SCAI-Lab/ros4healthcare/README.md

<h1 align="center">
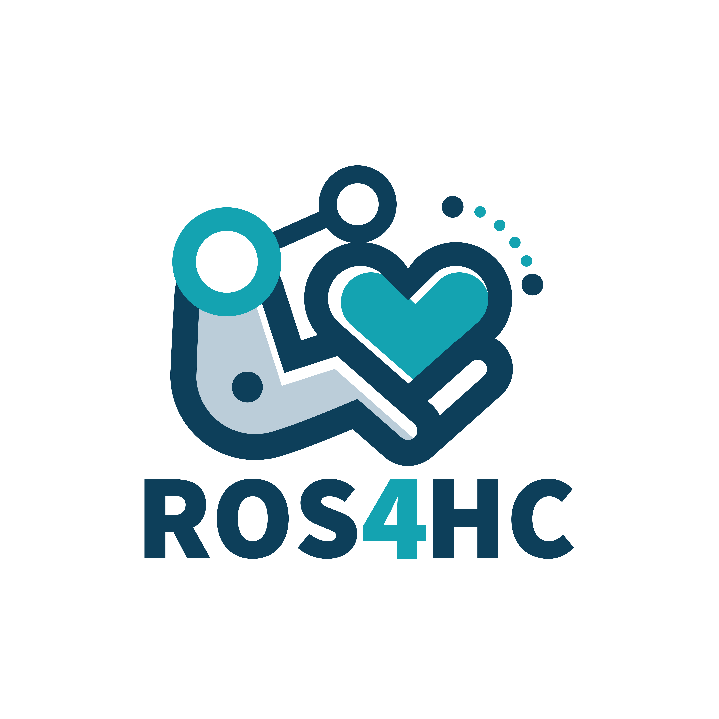
[picture p1: assets/ROS4HC_Logo.png]

</h1><br>

# ROS4Healthcare

Welcome to the **ROS4Healthcare** project! This repository contains ROS2 packages for healthcare applications, including message definitions, drivers, libraries, tools, and examples. **`ros4hc`** serves as an example of how one can use biosignals coming from wearable medical devices like Vivalink and mbient wristbands to track patients' activities. In addition, we have developed an Activities of Daily Living (ADL) classifier that will help doctors visualize their patients' daily activity patterns and consequently help them recommend a suitable routine. This can be visualised through our `healthcare_wheelchair_dashboard`.

## Repository Structure

- **`ros4hc_drv`**: Includes drivers for various biosensors.
- **`ros4hc_examples`**: Example applications and use cases demonstration.
- **`ros4hc_lib`**: Libraries.
- **`ros4hc_msgs`**: Contains all message definitions and structure for sensor data.
- **`ros4hc_launch`**: Example launch files.
- **`ros4hc_devices`**: Buildable affordable devices that work with ROS4HC.

## Setup

## **Prerequisites**
- Ensure **ROS 2 Humble** installed.

- Source ROS 2 :
  ```bash
  source /opt/ros/humble/setup.bash
  ```

Now clone the repo into our workspace

```bash
mkdir -p ~/ros2_ws/src
cd ~/ros2_ws/src
git clone --recurse-submodules https://github.com/ros-healthcare/ros4healthcare
cd ~/ros4healthcare
```
### **Build `ros4hc_msgs` and `ros4hc_drv`**
```bash
colcon build --packages-select ros4hc_msgs ros4hc_drv --symlink-install
source install/setup.bash
```

## Running the Drivers

We have included drivers for several devices in the `ros4hc_drv` repository.

Each driver receives either a device mac address or a file path as a parameter. Feel free to change the parameters in the respective config/params.yaml
file for each device driver.

To run the driver for BLE devices, make sure the PC Bluetooth is on, the device is charged and is nearby, then run the driver

by running ```ros2 launch package_name launch_file```  

To run our dashboard, we will need to connect to the mbient sensor and to the sensomative mat, for this run:

```
ros2 launch mbient_ros mbient_node.launch.py
```

in a new terminal, source the repo and run the sensomative launch file

```
source install/setup.bash
ros2 launch sensomative_ros sensomative_node.launch.py
```

## Running ADL Classifier 

In order to have our model classify the data coming from the wearable devices, we need to run the healthcare_adl_classifier

To do this open a new tab, source the repo and run

```
source install/setup.bash
ros2 run healthcare_adl_classifier pub_adl
```

We first need to make sure our python environment is well set up

simply run ```pip install -r requirements.txt``` to install the dependencies

We then need to clone the repositories into our workspace

```bash
cd ros2_ws/src
git clone --recurse-submodules https://github.com/ros-healthcare/ros4healthcare
cd ..
```
then build and source the workspace 

```
colcon build --symlink-install
source install/setup.bash
```

# Acknowledgments

<!-- ![JST Moonshot R&D Logo](https://example.com/jst_logo.png)  ![ETH-SPS Logo](https://example.com/eth_logo.png) -->

This work was partially supported by:

- The JST Moonshot R&D Program [Grant Number JPMJMS2034]
- The ETH-SPS Digital Transformation in Personalized Health Care for SCI [Grant Number: 2021-HS-348]

<h1 align="center">
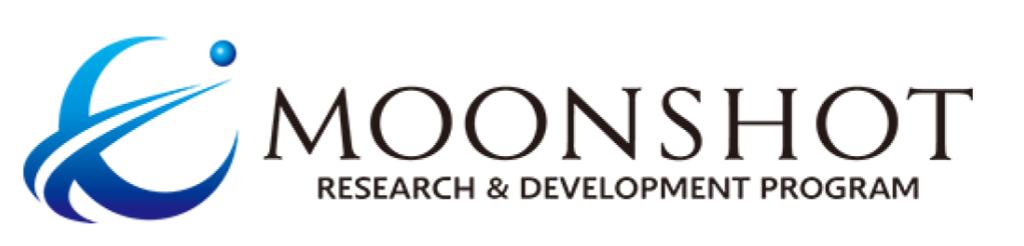
[picture p2: assets/JST_Logo.png]

</h1><br>
