SCAI-Lab/ros4healthcare/ros4hc_devices/M5StickC PLUS2/README.md

*M5StickC PLUS2 as an Accelerometer sensor*

This is the base code for using the M5StickC PLUS2 as a ROS2 compatible accelerometer sensor
