SCAI-Lab/ros4healthcare/ros4hc_examples/applications/healthcare_wheelchair_dashboard/dashboard/resource/Dashboard-Vectors/CircleProcess.png

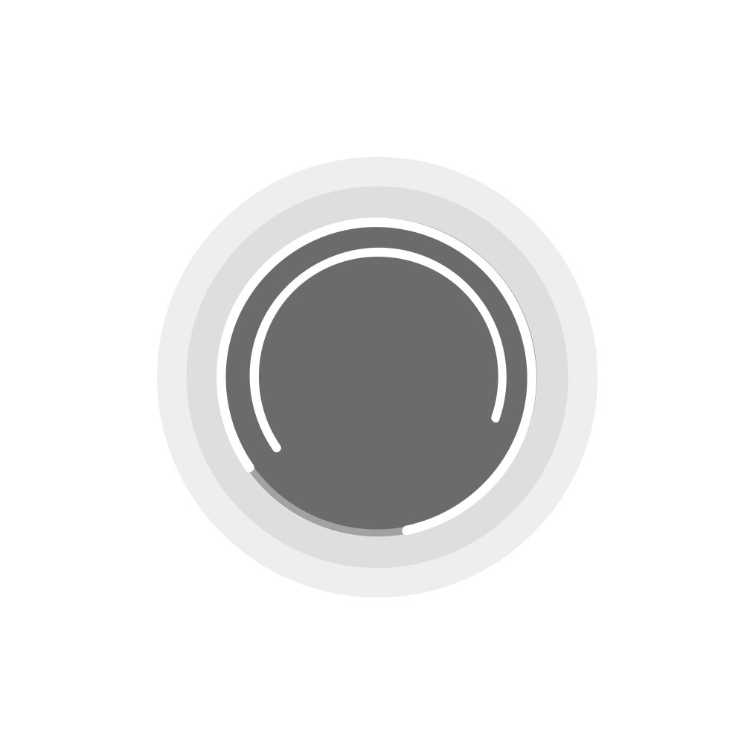
ros4hc_examples/applications/healthcare_wheelchair_dashboard/dashboard/resource/Dashboard-Vectors/CircleProcess.png
