SCAI-Lab/ros4healthcare/ros4hc_examples/applications/healthcare_wheelchair_dashboard/dashboard/resource/Dashboard-Vectors/Sleep_Pose_Left.png

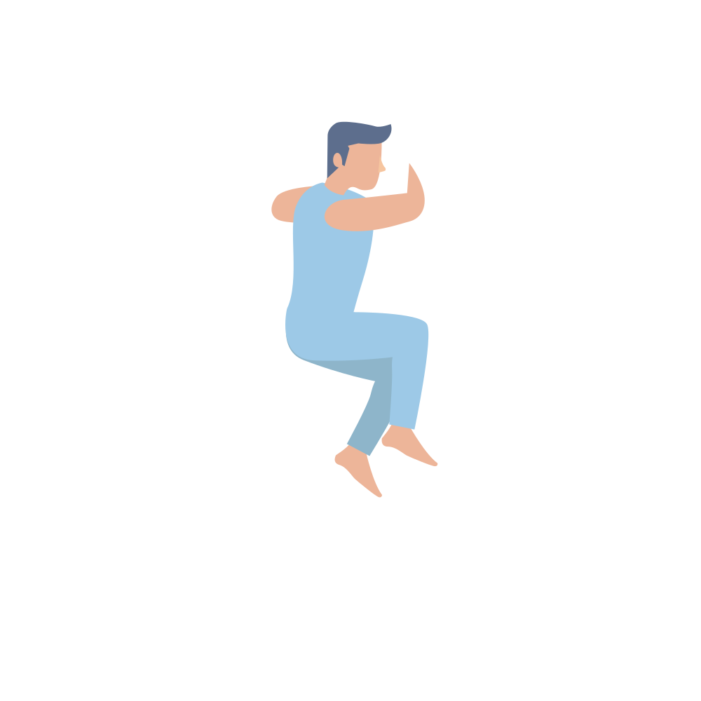
ros4hc_examples/applications/healthcare_wheelchair_dashboard/dashboard/resource/Dashboard-Vectors/Sleep_Pose_Left.png
