SCAI-Lab/ros4healthcare/ros4hc_devices/Seeed Studio mmWave MHR60A/Case-top.3mf

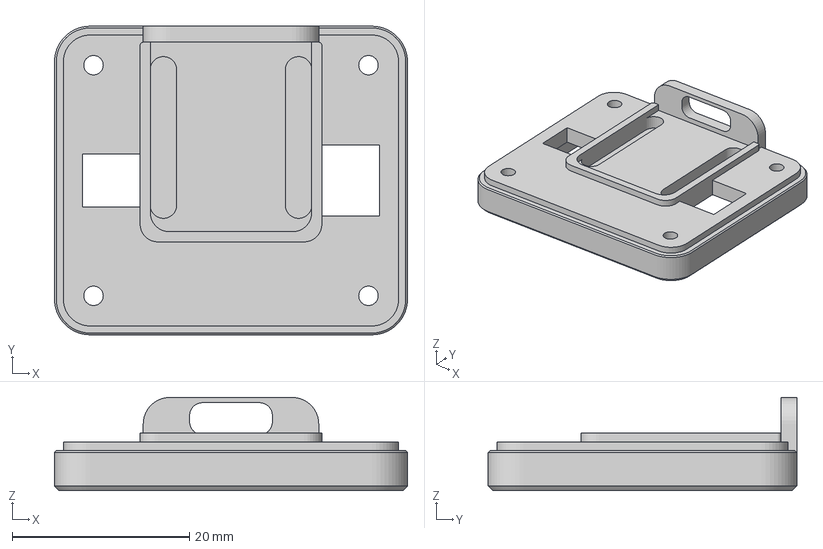
[picture p34: CAD file, 2026-04-10]
ros4hc_devices/Seeed Studio mmWave MHR60A/Case-top.3mf
39.8 x 34.8 x 10.5 mm
