SCAI-Lab/ros4healthcare/ros4hc_devices/MAX30100/lower-clip-lid.3mf

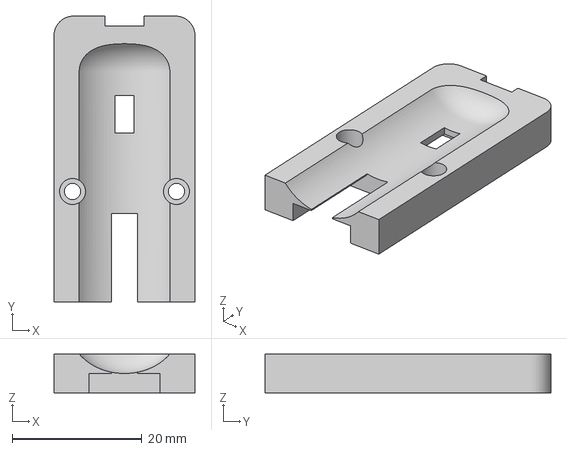
[picture p35: CAD file, 2026-04-10]
ros4hc_devices/MAX30100/lower-clip-lid.3mf
21.7 x 44.0 x 6.00 mm
