SCAI-Lab/ros4healthcare/ros4hc_devices/Seeed Studio mmWave MHR60A/mmWave v4.step

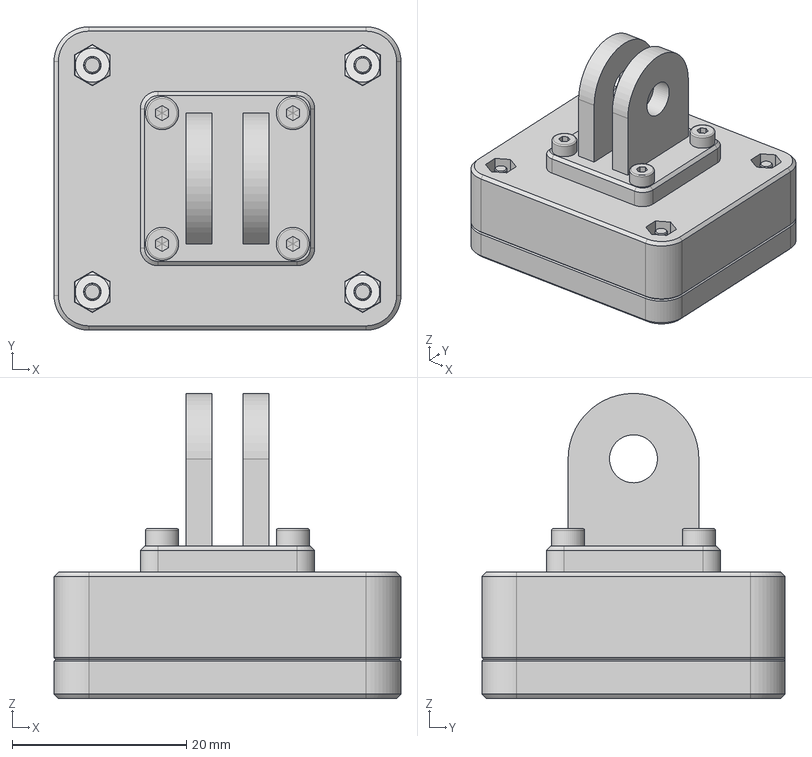
[picture p38: CAD file, 2026-04-10]
ros4hc_devices/Seeed Studio mmWave MHR60A/mmWave v4.step
39.8 x 34.8 x 35.0 mm
Case-top
BOSS-EXTRUDE14_8_
BOSS-EXTRUDE7_4_
BOSS-EXTRUDE7_3_
BOSS-EXTRUDE14_4_
BOSS-EXTRUDE14_2_
BOSS-EXTRUDE14_11_
BOSS-EXTRUDE7_7_
BOSS-EXTRUDE14_9_
BOSS-EXTRUDE14_3_
BOSS-EXTRUDE14_7_
MIRROR2
BOSS-EXTRUDE14_5_
BOSS-EXTRUDE14_12_
BOSS-EXTRUDE7_8_
BOSS-EXTRUDE7_1_
BOSS-EXTRUDE14_10_
BOSS-EXTRUDE7_9_
BOSS-EXTRUDE14_6_
BOSS-EXTRUDE14_1_
BOSS-EXTRUDE7_6_
BOSS-EXTRUDE7_2_
CUT-EXTRUDE5
BOSS-EXTRUDE7_5_
U.FL Connector v1
Button (1) x 2
Shield
Case-bottom
Go-Pro Mount
ISO 4762 - M2 x 12 Steel 4.6 Plain x 4
ISO 4032 - M2 Steel 6 Plain x 8
ISO 4762 - M2 x 6 Steel 4.6 Plain x 4
