SCAI-Lab/ros4healthcare/ros4hc_devices/MAX30100/Upper-clip.3mf

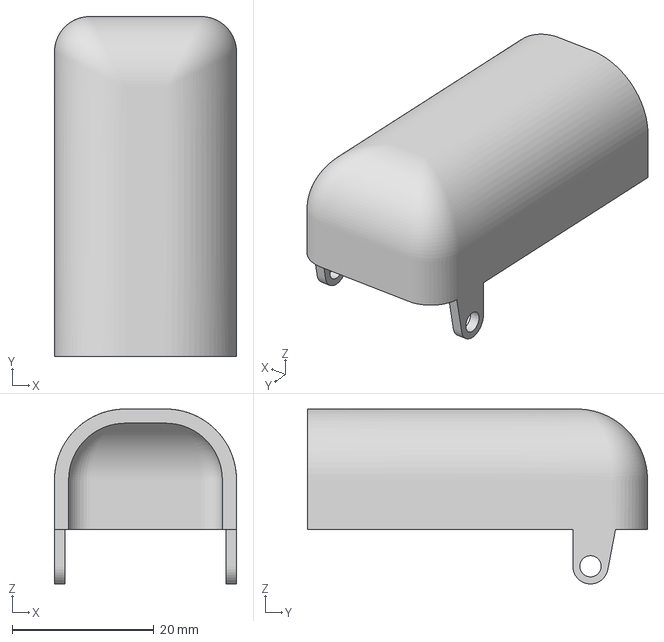
[picture p39: CAD file, 2026-04-10]
ros4hc_devices/MAX30100/Upper-clip.3mf
25.7 x 48.0 x 24.7 mm
