SCAI-Lab/ros4healthcare/ros4hc_devices/Seeed Studio mmWave MHR60A/Go-Pro Mount.3mf

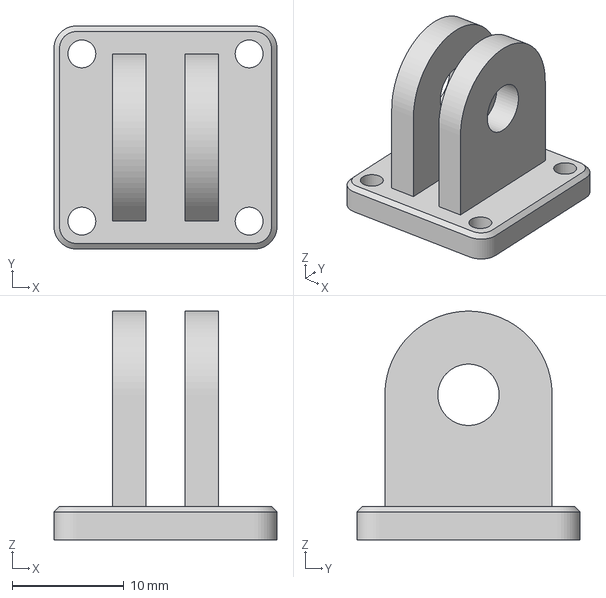
[picture p40: CAD file, 2026-04-10]
ros4hc_devices/Seeed Studio mmWave MHR60A/Go-Pro Mount.3mf
20.0 x 20.0 x 20.5 mm
