SCAI-Lab/ros4healthcare/(list of files, cad)

Other CAD files:
ros4hc_devices/MAX30100/PPG Clip v7.f3z
ros4hc_devices/Seeed Studio mmWave MHR60A/mmWave v4.f3z
