SCAI-Lab/ros4healthcare/(commit log)

2025-05-12 add M5 sensor drivers
2025-10-27 New corsano driver
2026-04-07 Added devices folder
    [Case-bottom.3mf, Case-top.3mf, Go-Pro Mount.3mf, mmWave v4.f3z, mmWave v4.step]
2026-04-07 Added new devices and pictures
    [PPG Clip v7.f3z, PPG Clip v7.step, Upper-clip.3mf, clip.3mf, lower-clip-lid.3mf]
2026-04-07 Added mmWave driver
2026-04-07 Fixed driver name
2026-04-07 Fixed sensomative driver improved performance of the pressure visualizer
2026-04-07 fixed bluetooth_common to allow notifications and reads, split pressure_visualizer into it's own package
